masonmcg/SquidSafe/README.md

# SquidSafe
Motorcycle wheelie control for my DRZ400SM using Raspberry Pi
