masonmcg/SquidSafe/INFO/Presentation.pdf

# Motorcycle wheelie control

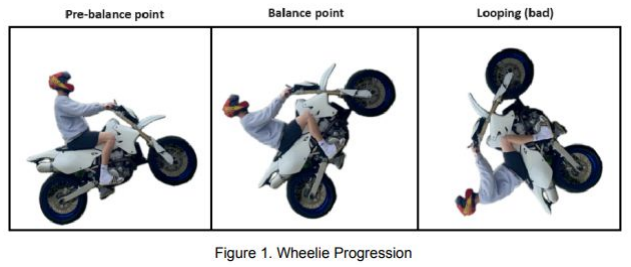
[picture p1: figure]

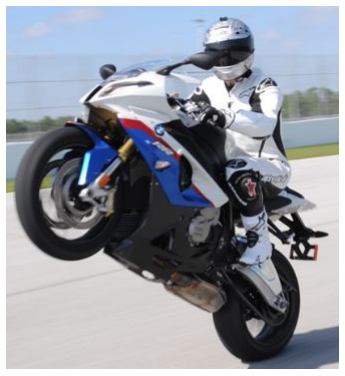
[picture p2: figure]

## Project goals

- Add wheelie control to my 90s technology bike
- Determine the angle with an IMU sensor, and limit the engine power when above the desired angle
- Cut the spark signal to limit engine power
- Hopefully switch this fast enough to remain at the same angle while at full throttle

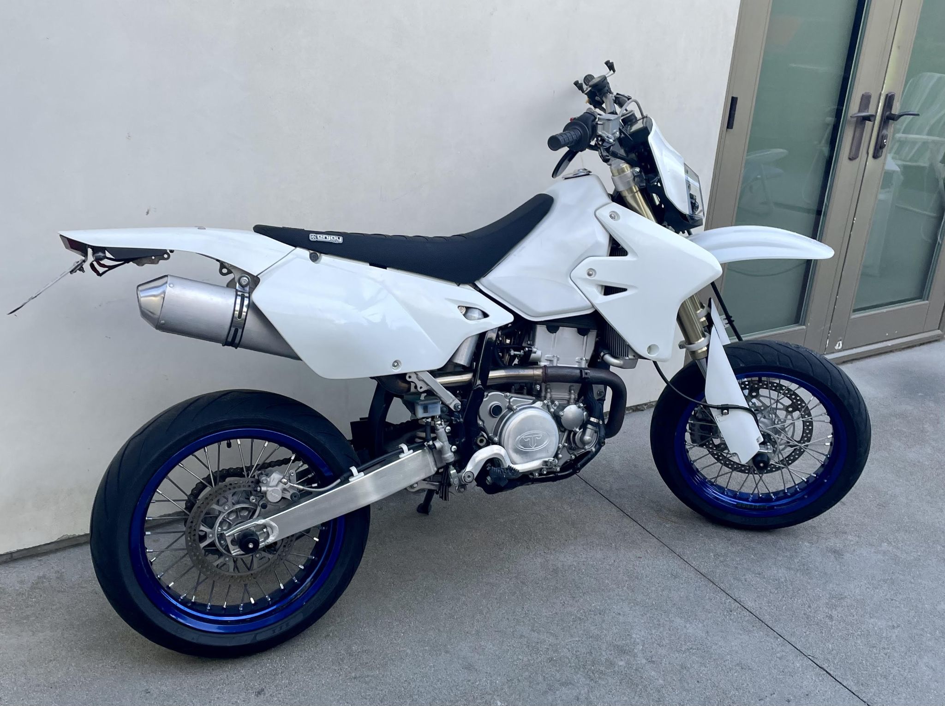
[picture p3: figure]

## Result

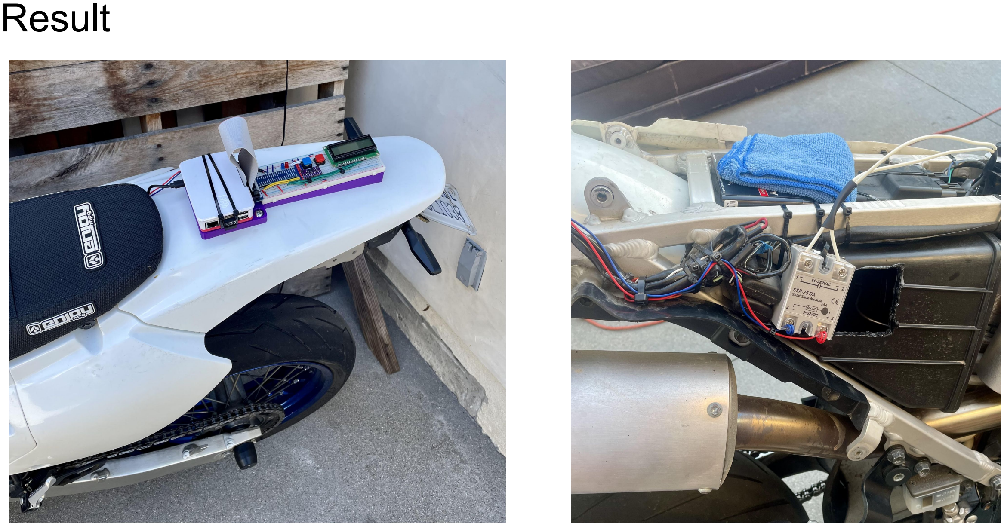
[picture p4: page 3]

## Component selection

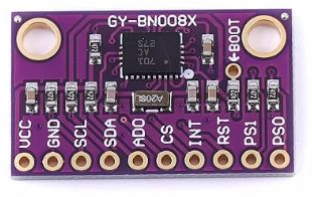
[picture p5: figure]

IMU sensor - BNO085

- Built in sensor fusion
- 400Hz angle refresh

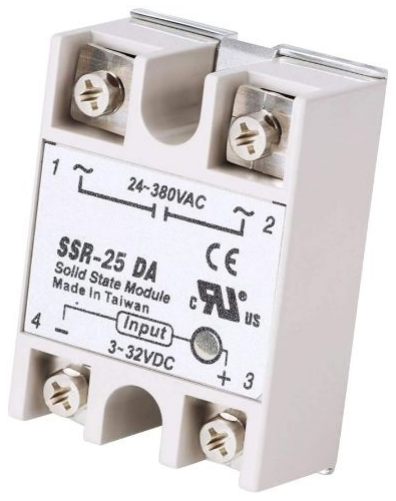
[picture p6: figure]

Relay - SSR-25DA

- DC - AC
- Solid state
- Input voltage: 3-32V DC
- Output voltage: 24-380V AC

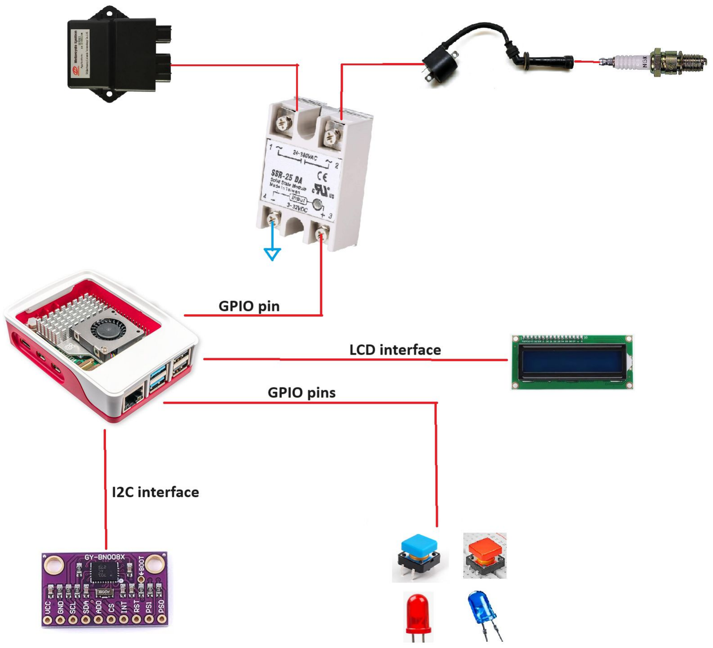
[picture p7: figure]

## System architecture

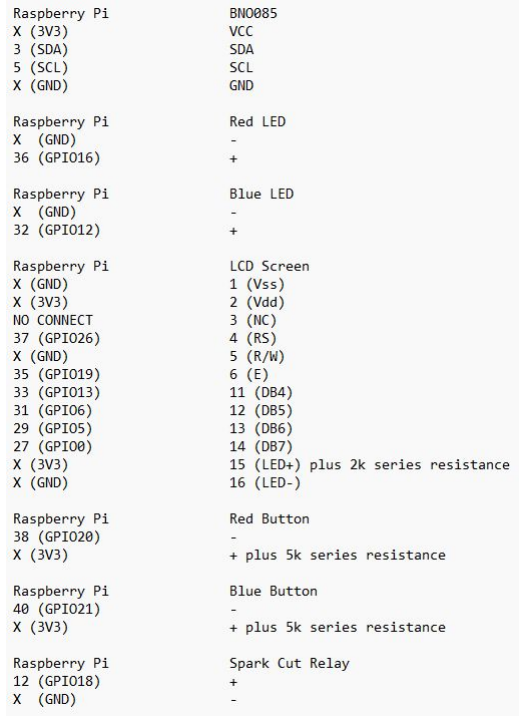
[picture p8: figure]

## System architecture

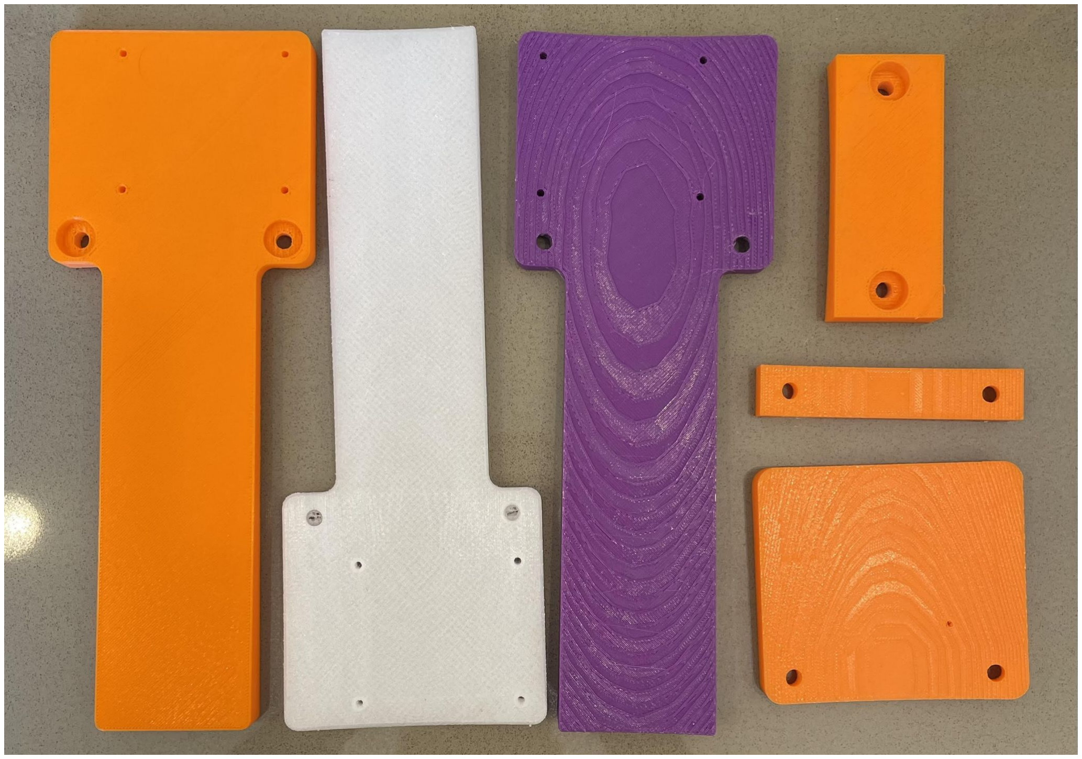
[picture p9: figure]

## Challenges

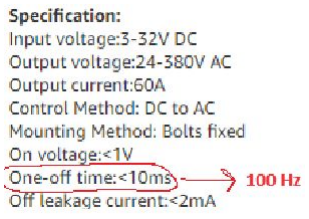
[picture p10: figure]
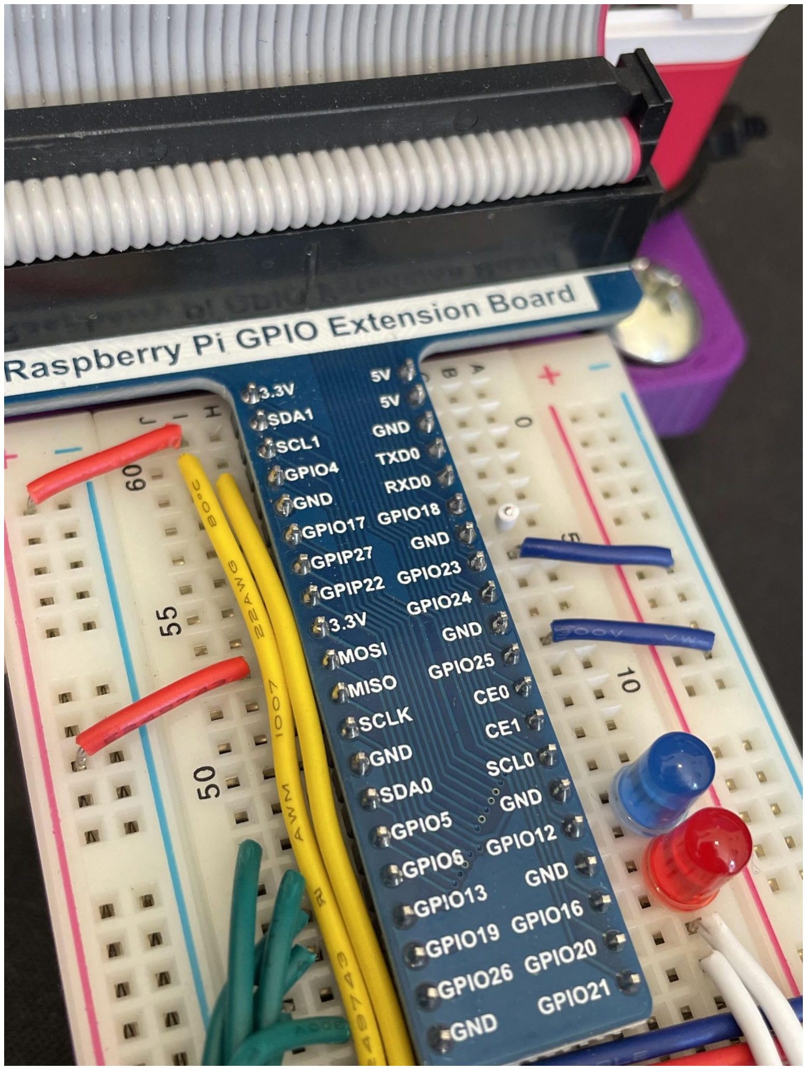
[picture p11: figure]

- 3d printing/designing mount
- Frying the Pi
- Sensor/relay not fast enough
- OS Errors with GPIO pins

## Future improvements

- IMU calibration
- Using raw gyro data instead of corrected (reduce delay)
- Faster switching relay
- Glue everything to the breadboard (LCD fell off during testing)

## Demo

https://youtu.be/qjaUx9cg5qc
