masonmcg/SquidSafe/SCHEMATICS/rpi_pinout.png

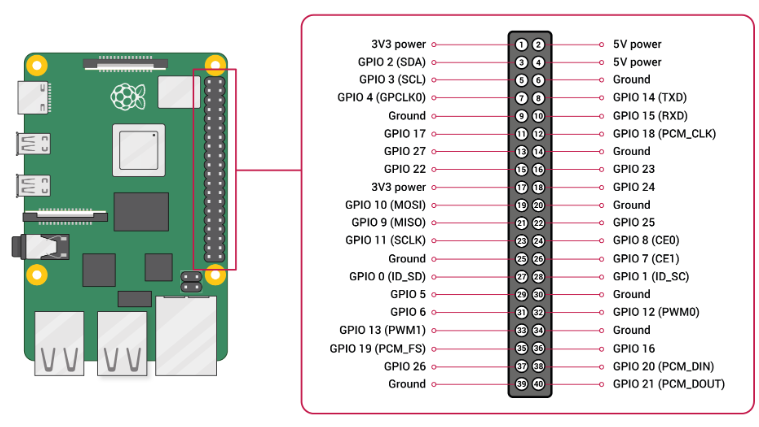
SCHEMATICS/rpi_pinout.png
