masonmcg/SquidSafe/CAD/MountPlateV6.stl

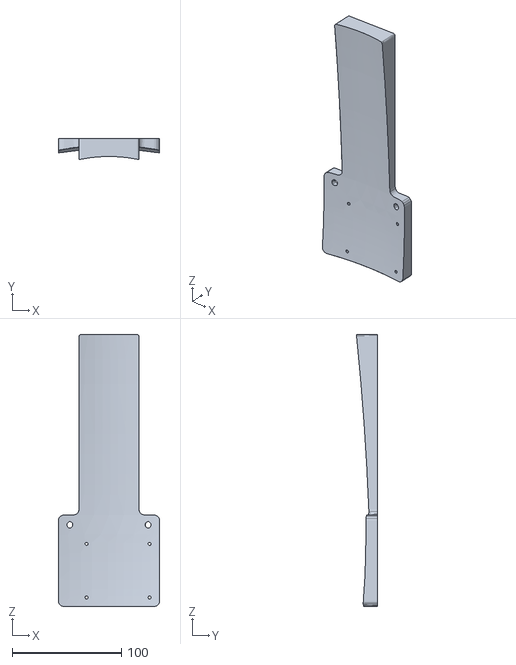
[picture p13: CAD file, 2024-06-05]
CAD/MountPlateV6.stl
92.6 x 19.2 x 248.8
