masonmcg/SquidSafe/CAD/MountPlateV5.stl

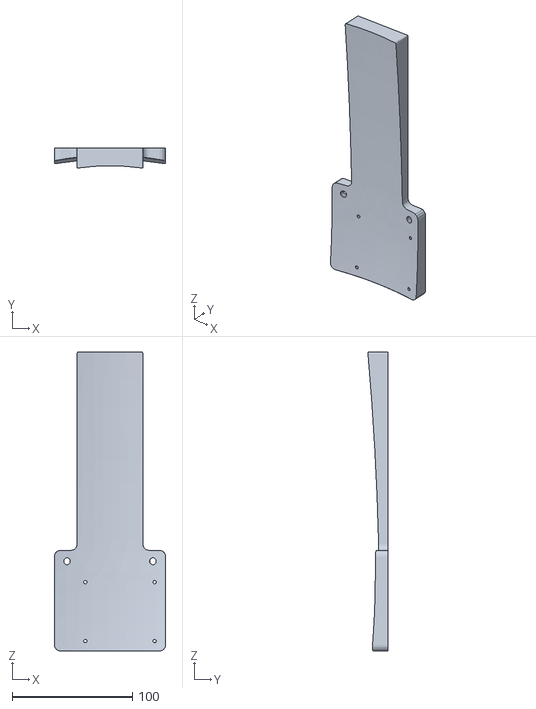
[picture p14: CAD file, 2024-05-30, an earlier design]
CAD/MountPlateV5.stl
92.6 x 16.8 x 248.8
