masonmcg/SquidSafe/CAD/MountPlateV3.stl

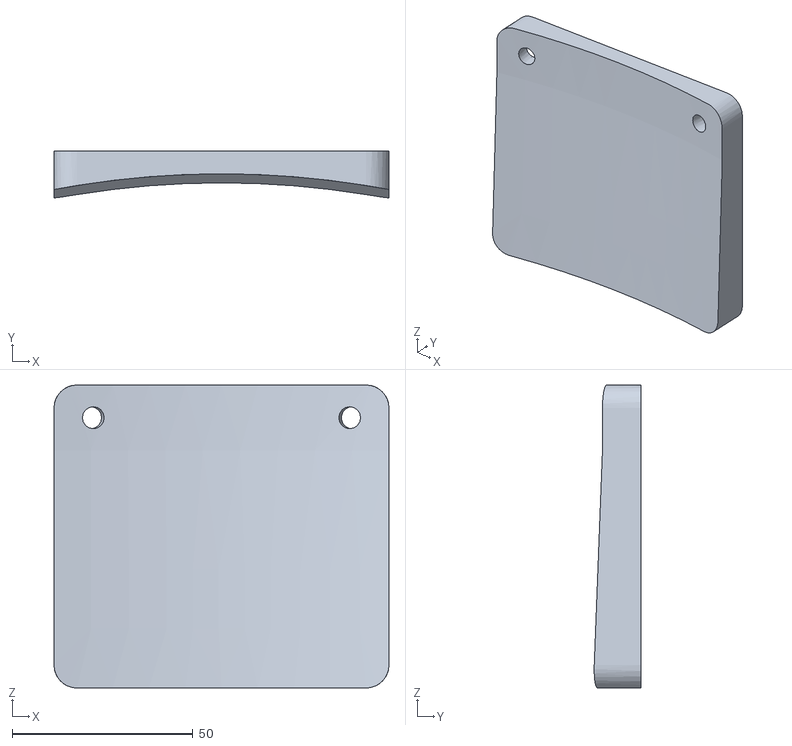
[picture p15: CAD file, 2024-05-29, an earlier design]
CAD/MountPlateV3.stl
92.6 x 12.9 x 83.7
