masonmcg/SquidSafe/CAD/MountPlateV4.stl

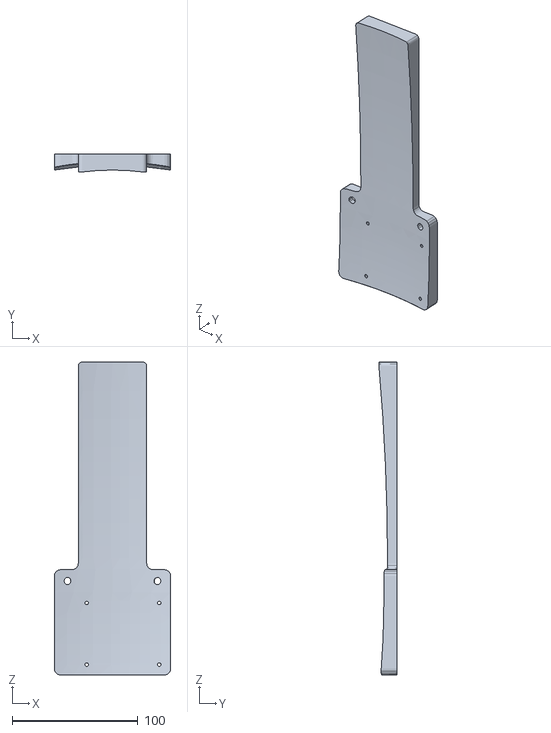
[picture p16: CAD file, 2024-05-29, an earlier design]
CAD/MountPlateV4.stl
92.6 x 14.7 x 248.8
