masonmcg/SquidSafe/CAD/MountPlateV2.stl

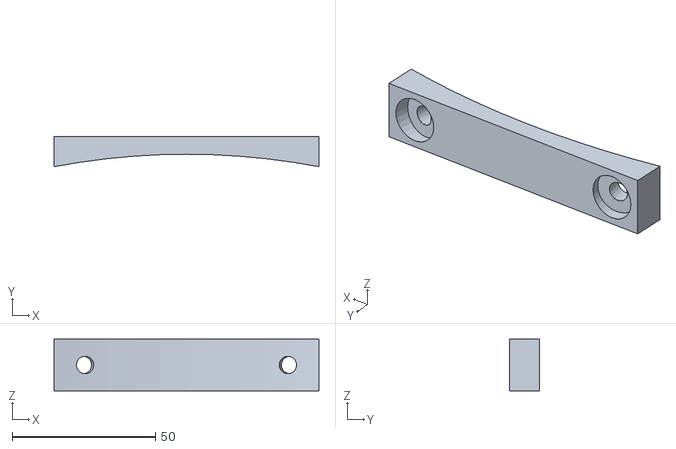
[picture p17: CAD file, 2024-05-28, an earlier design]
CAD/MountPlateV2.stl
92.6 x 10.6 x 18.1
