masonmcg/SquidSafe/CAD/MountPlateV1.stl

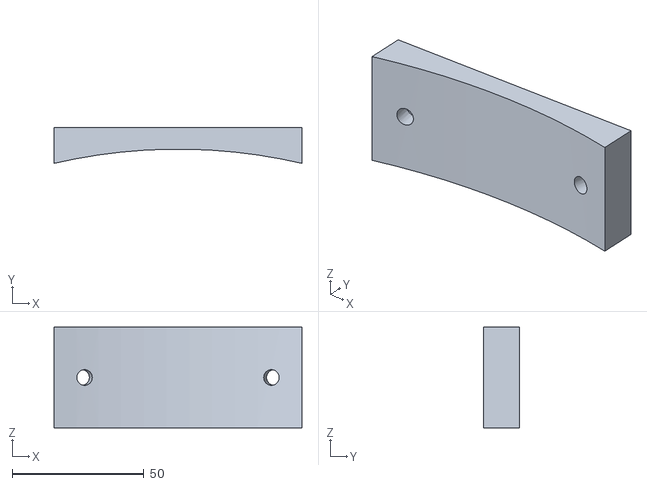
[picture p18: CAD file, 2024-05-27, an earlier design]
CAD/MountPlateV1.stl
94.0 x 13.5 x 38.1
