masonmcg/SquidSafe/(list of files, cad)

Other CAD files:
CAD/MountPlateV1.ipt
CAD/MountPlateV2.ipt
CAD/MountPlateV3.ipt
CAD/MountPlateV4.ipt
CAD/MountPlateV5.ipt
CAD/MountPlateV6.ipt
CAD/OldVersions/MountPlateV3.0001.ipt
CAD/OldVersions/MountPlateV4.0001.ipt
CAD/OldVersions/MountPlateV5.0001.ipt
CAD/OldVersions/MountPlateV6.0002.ipt
