masonmcg/SquidSafe/(commit log)

2024-05-26 added schematic/pinout
2024-05-26 added raspberry pi schematic
2024-05-26 added LED that turns on at specific pitch angle to code and schematic
2024-05-27 added buttons to pinout
2024-05-27 added button functionality
2024-05-27 added button interface functionality
2024-05-27 added version 1 of mounting plate in CAD folder
    [MountPlateV1.ipt, MountPlateV1.stl]
2024-05-28 added mount plate v2
    [MountPlateV2.ipt, MountPlateV2.stl]
2024-05-29 added new mount plate revisions
    [MountPlateV3.0001.ipt, MountPlateV3.ipt, MountPlateV3.stl, MountPlateV4.0001.ipt, MountPlateV4.ipt, MountPlateV4.stl]
2024-05-30 added mountplate v5
    [MountPlateV5.0001.ipt, MountPlateV5.ipt, MountPlateV5.stl]
2024-06-05 added final mount plate revision
    [MountPlateV6.0002.ipt, MountPlateV6.ipt, MountPlateV6.stl]
2024-06-05 added dlay to avoid OS error, and commented out file recording stuff
    [squidsafe.py]
2024-06-06 fixed a bunch of stuff and changed wheelie angle polarity
    [squidsafe.py]
2024-06-06 fixed a couple thigs
    [squidsafe.py]
2024-06-06 added graphic schematic
